sharkiteuthis/TOBI-Platform/TOBI Data.jpg

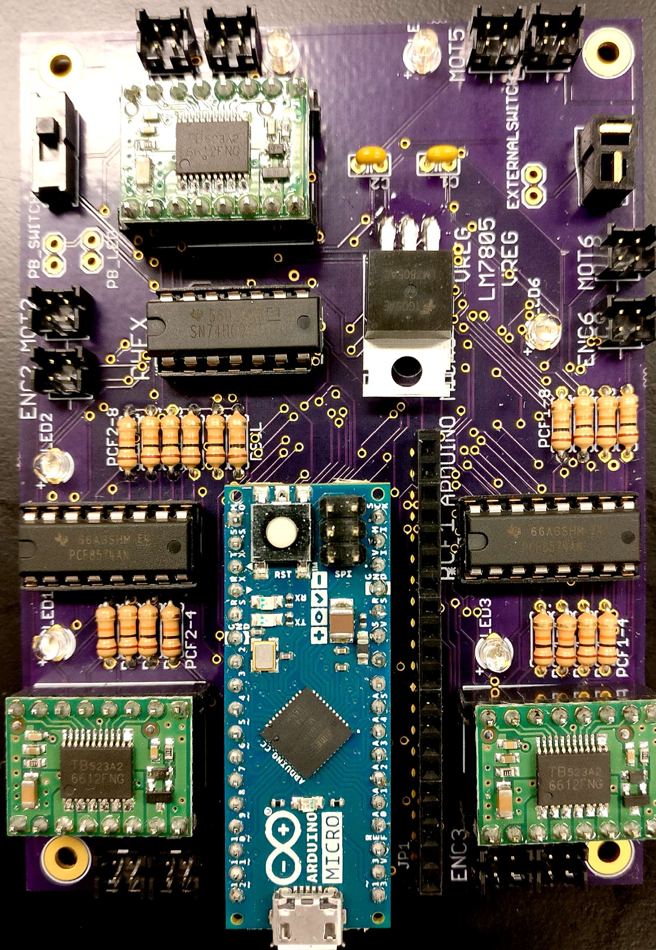
TOBI Data.jpg
