sharkiteuthis/TOBI-Platform/tobi diagram UPDATED.jpg

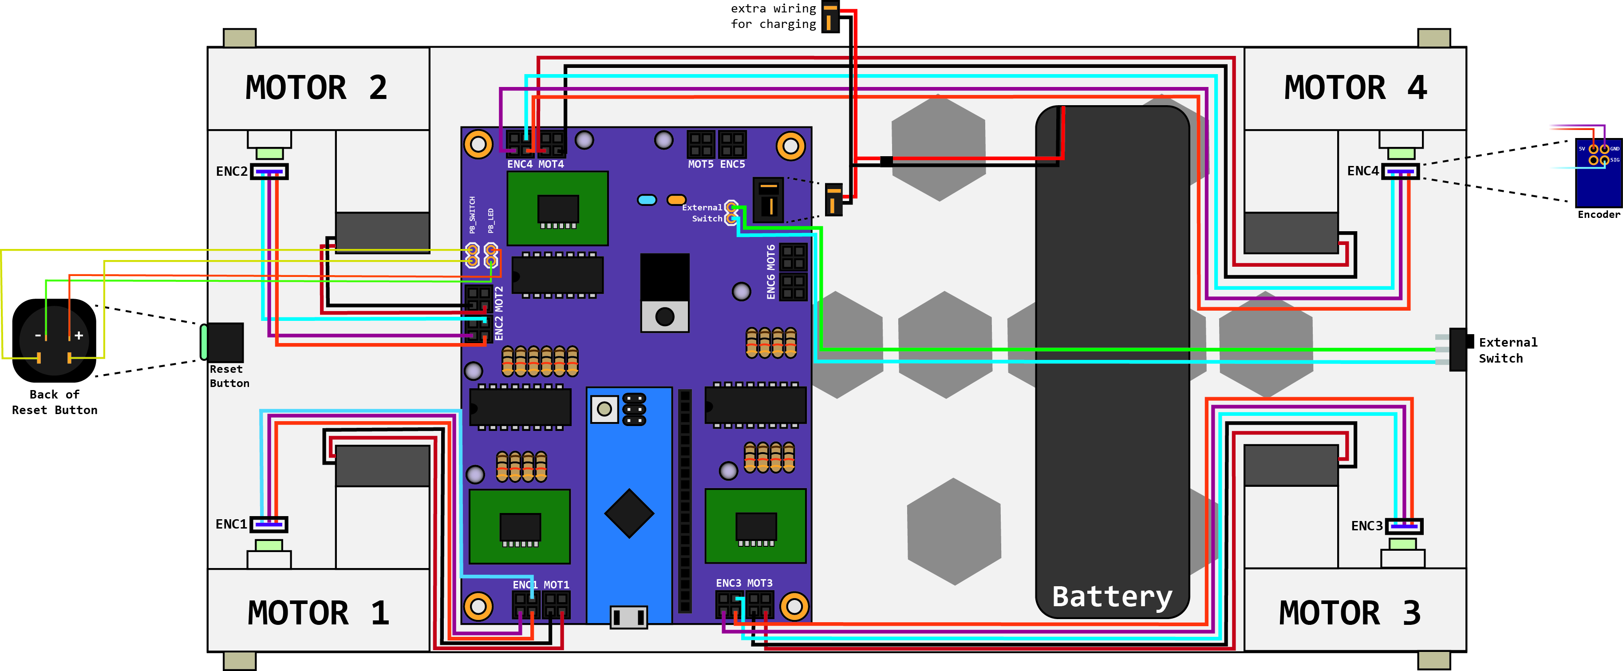
tobi diagram UPDATED.jpg
