sharkiteuthis/TOBI-Platform/TOBI - BOM.xlsx

Sheet: For robot
TOBI BOM | Per Bot | Supplier | Part No | Description | Cost | Per | cost per part | Cost per robot | URL | Notes
PCB
Custom PCB | 1 | Custom
Motor Drivers | 3 | Polulu | TB6612FNG | Dual Motor Driver Carrier | $4.25 | $1.00 | $4.25 | $12.75 | https://www.pololu.com/product/713
Female Headers 2x2 | 12 | Digikey | H2019-ND (http://www.digikey.com/scripts/DkSearch/dksus.dll?Detail&itemSeq=222470643&uq=636255435022141425) | CONN SOCKET 4POS 2MM DUAL CRIMP | $6.86 | $50.00 | $0.14 | $1.65 | https://www.digikey.com/products/en?keywords=H2019-ND
Male Headers 2x2 | 12 | Digikey | H10229-ND | CONN HEADER 4POS 2MM PCB TIN | $29.90 | $100.00 | $0.30 | $3.59 | https://www.digikey.com/products/en?keywords=H10229-ND
IO Expander | 2 | Digikey | 296-13106-5-ND | IC I/O EXPANDER I2C 8B 16DIP | $28.90 | $24.00 | $1.20 | $2.41 | https://www.digikey.com/products/en?keywords=296-13106-5-ND
Hex Inverter | 1 | Digikey | 296-1566-5-ND | Hex Inverter | $0.52 | $1.00 | $0.52 | $0.52 | https://www.digikey.com/product-detail/en/texas-instruments/SN74HC04N/296-1566-5-ND/277212
Voltage Regulator | 1 | Digikey | LM7805ACT-ND | IC REG LDO 5V 1A TO220-3 | $6.37 | $12.00 | $0.53 | $0.53 | https://www.digikey.com/products/en?keywords=LM7805ACT-ND
Resistors 10 k-ohm | 18 | Digikey | CF14JT10K0TR-ND | RES 10K OHM 1/4W 5% AXIAL | $23.75 | $5000.00 | $0.00475 | $0.09 | https://www.digikey.com/products/en?keywords=CF14JT10K0TR-ND
Femal Headers 1x20 | 8 | Digikey | S7018-ND | CONN HEADER FEMALE 20POS.1" TIN | $12.72 | $10.00 | $1.27 | $10.18 | https://www.digikey.com/products/en?keywords=S7018-ND
Arduino Micro | 1 | Pololu | Micro | Arduino Micro | $24.95 | $1.00 | $24.95 | $24.95 | https://www.pololu.com/product/2188
Capacitor 0.33 (Vreg) | 1 | Digikey | 490-7544-1-ND | AP CER 0.33UF 50V X7R RADIAL | $3.95 | $10.00 | $0.40 | $0.40 | https://www.digikey.com/products/en?keywords=490-7544-1-ND
Capacitor 0.1(Vreg) | 1 | Digikey | BC1160CT-ND | 0.1µF -20%, +80% 50V Ceramic Capacitor Y5V (F) Radial | $1.27 | $10.00 | $0.13 | $0.13 | https://www.digikey.com/products/en?keywords=BC1160CT-ND
Inverter Header | 1 | Digikey | AE9989-ND | CONN IC DIP SOCKET 14POS TIN | $0.23 |  |  |  | http://www.digikey.com/scripts/DkSearch/dksus.dll?Detail&itemSeq=231988762&uq=636343278581042423
I/O Expander Header | 2 | Digikey | AE9992-ND | CONN IC DIP SOCKET 16POS TIN | $0.25 |  |  |  | http://www.digikey.com/scripts/DkSearch/dksus.dll?Detail&itemSeq=231988761&uq=636343278581042423
Switch | 2 | Digikey | EG1903-ND | SWITCH SLIDE SPDT 200MA 30V | $0.58 |  |  |  | http://www.digikey.com/scripts/DkSearch/dksus.dll?Detail&itemSeq=231988763&uq=636343278581052424
LED | 1 | Digikey | R2D-1.5-BLU-ND | ORCA ADAPTER LT PIPE BLUE 3.4V (1=100 qty) | $2.32 |  |  |  | https://www.digikey.com/products/en?keywords=R2D-1.5-BLU-ND
Reset Button | 1 | Adafruit | 1440 | 16mm Illuminated Pushbutton - Green Momentary | $1.50 |  |  |  | https://www.adafruit.com/product/1440
Total |  |  |  |  |  |  |  | 57.17706667
Motors
Magnets | 6 | Digikey | 469-1024-ND | MAGNET ROUND NDFEB DIAMETRIC | $22.75 | 100 | 0.2275 | 1.365 | http://www.digikey.com/product-detail/en/radial-magnet-inc/8995/469-1024-ND/5126077
Motors | 6 | Polulu | GM8 143:1 | Solarbotics | 5.4 | 1 | 5.4 | 32.4 | https://www.pololu.com/product/187
Crimps | 30 | Digikey | H1504-ND | CONN SOCKET 24-28AWG CRIMP TIN | $18.75 | 250 | 0.075 | 2.25 | https://www.digikey.com/products/en/connectors-interconnects/rectangular-connectors-contacts/331?k=H1504-ND
Heat Shrink | 1 | Digikey | FP316K-R5-ND | HEATSHRK FP301 3/16"X0.5" (1=50 qty) | 1.5 | 50 | 0.03 | 0.03 | https://www.digikey.com/products/en?keywords=FP316K-R5-ND
Total |  |  |  |  |  |  |  | 36.015
Sensors
PCB Sensor Custom | 1 | Custom
Hall effect sensor | 6 | Digikey | AS5600-ASOMCT-ND | IC SENSOR MAG ROTARY 12BIT 8SOIC | 31.16 | 10 | 3.116 | 18.696 | https://www.digikey.com/products/en?keywords=AS5600-ASOMCT-ND
capacitor 0.1 uF | 1 | Digikey | 311-1369-6-ND | CAP CER 0.1UF 16V Y5V 0603 | 0.32 | 10 | 0.032 | 0.032 | https://www.digikey.com/products/en?keywords=%09311-1369-6-ND
capacitor 1 uF | 1 | Digikey | 311-1372-6-ND | CAP CER 1UF 16V Y5V 0603 | 0.89 | 10 | 0.089 | 0.089 | https://www.digikey.com/products/en?keywords=311-1372-6
Total |  |  |  |  |  |  |  | 18.728
Power
Batteries | 1 | Maxxpacks | #K708F | 1 9.6v 700mah NiMH 2/3 AA Pack | $36.00 | 1 | 36 | 36 | https://www.maxxpacks.com/product_info.php?products_id=2254%7B1%7D108 | 24 AWG Leads
Mini T connectors (Pair) | 4 | HobbyKing | 258000111-0 | Mini Black T Connector Pack (1=5 Pairs) | $2.24 | 5 | 0.448 | 1.792 | https://hobbyking.com/en_us/mini-black-t-connector-pack-5-pairs.html/?___store=en_us | Also called Mini-deans connectors | http://www.progressiverc.com/mini-t-plug-connectors.html
Total |  |  |  |  |  |  |  | 37.792
Body |  | Shapeways |  | Top and Bottom STL files
3D Print body | 1
3D Print motor hubs | 6
3D Print magnet hubs | 6
Breadboard | 1 | Adafruit | Half-size breadboard | PRODUCT ID: 64 | 5 | 1 | 5 | 5 | https://www.adafruit.com/product/64
Body bolts
PCB bolts
PCB nuts
Total
Grand total 1 bot |  |  |  |  |  |  |  | 113.6970667

Sheet: Tools
Extras + Tools
Wire cutters/strippers | 1
Crimper | 1 | Digikey | H9995-ND | Crimper | 1052.7 |  |  | https://www.digikey.com/product-detail/en/hirose-electric-co-ltd/DF11-TA2428HC/H9995-ND/141476
Soldering Iron | 1 | Digikey | WES51 | Weller Soldering station | $129 | 1 |  | https://www.digikey.com/product-detail/en/apex-tool-group/WES51/WES51-120V-ND/526397?WT.srch=1
Battery Charger | 1 | Maxxpacks | IMAX B6AC DUAL POWER LiPO AC/DC PEAK CHARGER AC & DC INPUT |  | $34.95 | 1 | 34.95 | https://www.maxxpacks.com/product_info.php?cPath=53_248&products_id=3184
Heat shrink gun | 1 | Master Appliance | PH-2200-1-A1-ND | Heat Shrink Gun | 185.98 |  |  | https://www.digikey.com/product-detail/en/master-appliance-co/PH-2200-1-A1/PH-2200-1-A1-ND/1765524
Screw driver | 1 | Philips head
Solder wire | 1 | Amazon |  | BNTECHGO 3Pack Solder Wire Dia.1.0mm/0.039 Inch Sn99 Ag0.3 Cu0.7 Flux 2.0% Rosin Core Net Weight 0.71 Oz/20g | 10.98 | 3 |  | https://www.amazon.com/dp/B01N9SD9XA
Solder Paste | 1 | Digikey |  | Solder Paste |  |  |  | https://www.digikey.com/product-detail/en/chip-quik-inc/SMDLTLFP/SMDLTLFP-ND/2682721
Twezers | 1
Smoke Absorber | 1 | Digikey | 243-1189-ND | Aven Smoke Absorber | 52.05 | 1 |  | https://www.digikey.com/product-detail/en/aven-tools/17701/243-1189-ND/2815652
Brass Sponge | 1 | Digikey | 243-1157-ND | Aven Brass Sponge | 4.49 | 1 |  | https://www.digikey.com/product-detail/en/aven-tools/17530-TC/243-1157-ND/4926916
Micro USB
Wire Cutters | 1 | Digikey | LC665J-ND | Apex | $38 |  |  | https://www.digikey.com/product-detail/en/apex-tool-group/LC665J/LC665J-ND/4525229
PCB Stand | 1 | Digikey | 243-1223-ND | Aven | 13.08 |  |  | https://www.digikey.com/product-detail/en/aven-tools/17010/243-1223-ND/5252793
Solder Sucker | 1 | Digikey | 243-1182-ND | Aven | $5 |  |  | https://www.digikey.com/product-detail/en/aven-tools/17535/243-1182-ND/1992576
Multimeter | 1
