sharkiteuthis/TOBI-Platform/TOBI Order.xlsx

Vendor | Part No. | Description | Unit Qty | Qty | Total Cost | Total Cost | URL | Robots Needed
Polulu | TB6612FNG | Dual Motor Driver Carrier | 3 | 63 | 3.75 | 236.25 | https://www.pololu.com/product/713 | 21
Polulu | Polulu | GM8 143:1 | 7 | 147 | 5.4 | 793.8 | https://www.pololu.com/product/187
Digikey | H2019-ND | CONN SOCKET 4POS 2MM DUAL CRIMP | 13 | 273 | 0.11272 | 30.77256 | https://www.digikey.com/products/en?keywords=H2019-ND
Digikey | H10229-ND | CONN HEADER 4POS 2MM PCB TIN | 13 | 273 | 0.242 | 66.066 | https://www.digikey.com/products/en?keywords=H10229-ND
Digikey | 296-13106-5-ND | IC I/O EXPANDER I2C 8B 16DIP | 1 | 21 | 1.204 | 25.284 | https://www.digikey.com/products/en?keywords=296-13106-5-ND
Digikey | LM7805ACT-ND | IC REG LDO 5V 1A TO220-3 | 1 | 21 | 0.531 | 11.151 | https://www.digikey.com/products/en?keywords=LM7805ACT-ND
Digikey | CF14JT10K0TR-ND | RES 10K OHM 1/4W 5% AXIAL | 20 | 420 | 0.0099 | 4.158 | https://www.digikey.com/products/en?keywords=CF14JT10K0TR-ND
Digikey | S7018-ND | CONN HEADER FEMALE 20POS.1" TIN | 9 | 189 | 0.942 | 178.038 | https://www.digikey.com/products/en?keywords=S7018-ND
Digikey | 490-7544-1-ND | AP CER 0.33UF 50V X7R RADIAL | 2 | 42 | 0.435 | 18.27 | https://www.digikey.com/products/en?keywords=490-7544-1-ND
Digikey | BC1160CT-ND | 0.1µF -20%, +80% 50V Ceramic Capacitor Y5V (F) Radial | 2 | 42 | 0.127 | 5.334 | https://www.digikey.com/product-detail/en/vishay-bc-components/K104Z15Y5VF5TL2/BC1160CT-ND/286782
Digikey | 469-1024-ND | MAGNET ROUND NDFEB DIAMETRIC | 7 | 147 | 0.1697 | 24.9459 | https://www.digikey.com/products/en?keywords=469-1024-ND
Digikey | H1504-ND | CONN SOCKET 24-28AWG CRIMP TIN | 36 | 756 | 0.072 | 54.432 | https://www.digikey.com/products/en/connectors-interconnects/rectangular-connectors-contacts/331?k=H1504-ND
Digikey | FP316K-R5-ND | HEATSHRK FP301 3/16"X0.5" 1=50PC | 1 | 21 | 1.122 | 23.562 | https://www.digikey.com/products/en?keywords=FP316K-R5-ND
Digikey | AS5600-ASOMCT-ND | IC SENSOR MAG ROTARY 12BIT 8SOIC | 7 | 147 | 2.5797 | 379.2159 | https://www.digikey.com/products/en?keywords=AS5600-ASOMCT-ND
Digikey | 311-1369-6-ND | CAP CER 0.1UF 16V Y5V 0603 | 2 | 42 | 0.033 | 1.386 | https://www.digikey.com/products/en?keywords=%09311-1369-6-ND
Digikey | 311-1372-6-ND | CAP CER 1UF 16V Y5V 0603 | 2 | 42 | 0.094 | 3.948 | https://www.digikey.com/products/en?keywords=311-1372-6
Maxxpacks | #K708F | 1 9.6v 700mah NiMH 2/3 AA Pack w/ 24 AWG leads | 1 | 21 | 29.45 | 618.45 | https://www.maxxpacks.com/product_info.php?products_id=2254%7B1%7D108
HobbyKing | 258000111-0 | Mini Black T Connector Pack (1=5 Pairs) | 1 | 21 | 2.38 | 49.98 | https://hobbyking.com/en_us/mini-black-t-connector-pack-5-pairs.html/?___store=en_us
Adafruit | 64 | Half-Size Breadboard | 1 | 21 | 5 | 105 | https://www.adafruit.com/product/64
Arduino |  | Arduino Micro | 1 | 21 | 24.95 | 523.95 | https://store-usa.arduino.cc/products/a000053
OSH Park |  | PCB - Main | 1 | 22 | 150.27 | 3305.94 | https://oshpark.com/
OSH Park |  | PCB - Encoder | 6 | 126 | 0.4 | 50.4 | https://oshpark.com/
 |  |  |  |  | Total | 6510.33336
