sharkiteuthis/TOBI-Platform/PCB Files/TobiEncAS5600/Encoder BOM.xlsx

Component Description | QTY | Ref Des | Mfg P/N # | Manufacturer | Distributor P/N # | Notes:
IC SENSOR MAG ROTARY 12BIT 8SOIC | 1 | U1 | AS5600-ASOM | AMS | AS5600-ASOMCT
CAP CER 0.1UF 16V X7R 0603 | 1 | C2 | C0603C104M4RACTU | KEMET | 399-1099-1-ND | Any equivalent from different manufacturer is acceptable
CAP CER 1UF 16V X7R 0603 | 1 | C3 | CGA3E1X7R1C105M080AC | TDF Corporation | 445-12540-1-ND | Any equivalent from different manufacturer is acceptable
CONN HEADER 3 POS 2.54 | 1 | JP1 | 61300311121 | Wurth Electronics | DNI
