sharkiteuthis/TOBI-Platform/Solidworks files/ArduinoTobi_slim/slim_arduino_tobi_whole.SLDPRT

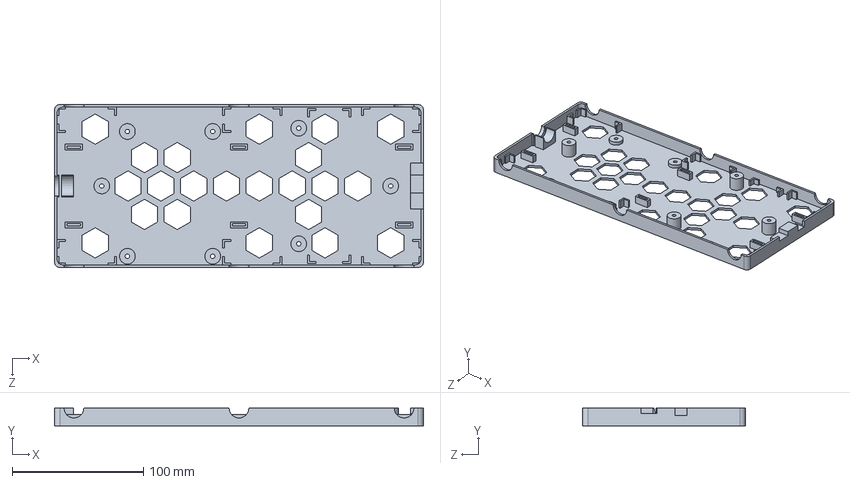
[picture p4: CAD file, 2017-12-02]
Solidworks files/ArduinoTobi_slim/slim_arduino_tobi_whole.SLDPRT
281.0 x 13.5 x 124.0 mm
