sharkiteuthis/TOBI-Platform/Solidworks files/assemblyCasing.SLDPRT

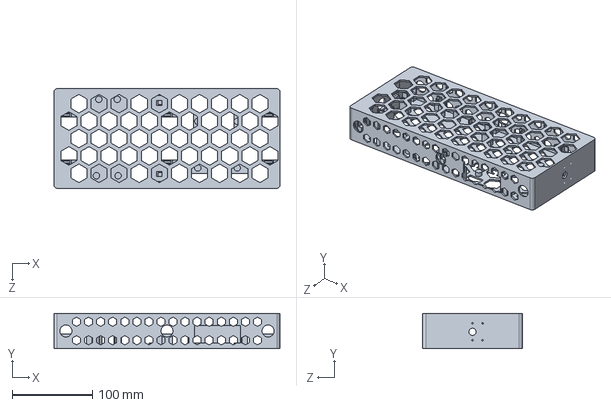
[picture p5: CAD file, 2017-12-02]
Solidworks files/assemblyCasing.SLDPRT
281.0 x 44.0 x 124.0 mm
