sharkiteuthis/TOBI-Platform/Solidworks files/t_hub_short.SLDPRT

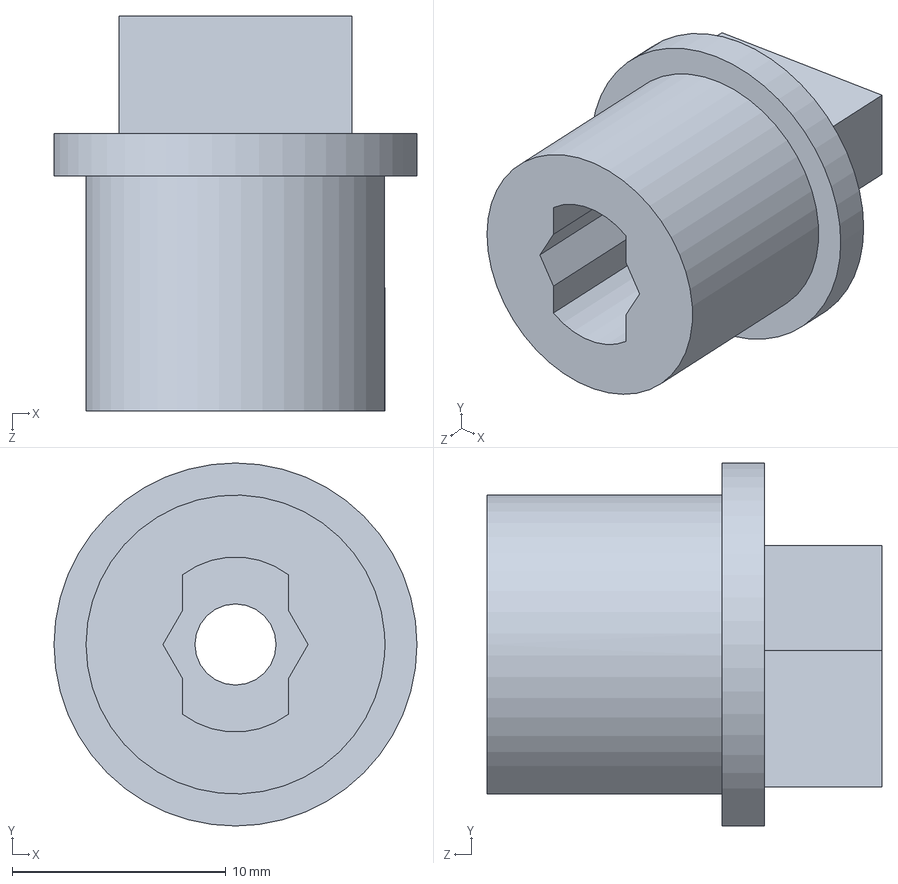
[picture p6: CAD file, 2017-12-02]
Solidworks files/t_hub_short.SLDPRT
17.0 x 17.0 x 18.5 mm
