sharkiteuthis/TOBI-Platform/Solidworks files/ArduinoTobi_slim/Body3.sldprt

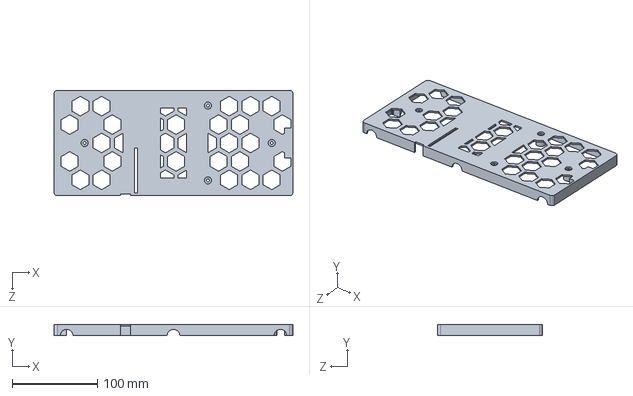
[picture p7: CAD file, 2017-12-02]
Solidworks files/ArduinoTobi_slim/Body3.sldprt
281.0 x 13.5 x 124.0 mm
