sharkiteuthis/TOBI-Platform/Solidworks files/battery holder.SLDPRT

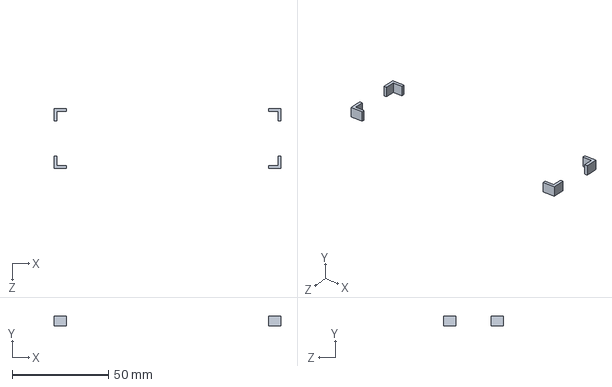
[picture p8: CAD file, 2017-12-02]
Solidworks files/battery holder.SLDPRT
118.0 x 5.00 x 31.0 mm
