sharkiteuthis/TOBI-Platform/Solidworks files/ArduinoTobi_slim/Body2.sldprt

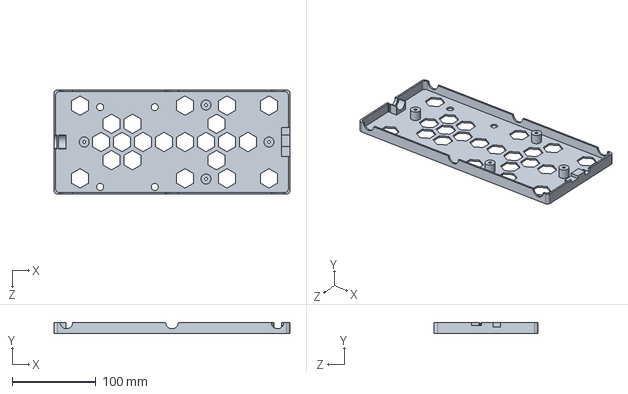
[picture p9: CAD file, 2017-12-02]
Solidworks files/ArduinoTobi_slim/Body2.sldprt
281.0 x 13.3 x 124.0 mm
