sharkiteuthis/TOBI-Platform/Solidworks files/Body1.sldprt

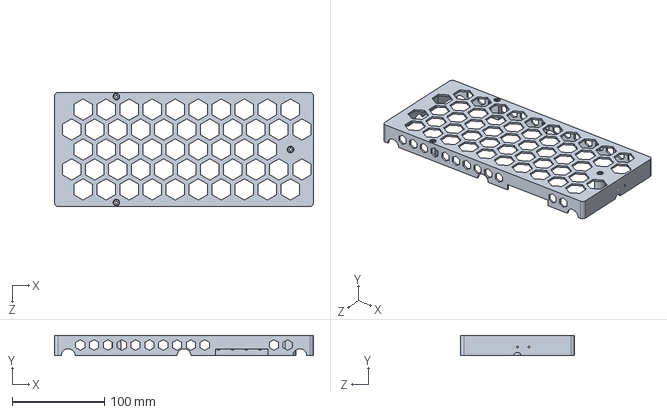
[picture p10: CAD file, 2017-12-02]
Solidworks files/Body1.sldprt
281.0 x 22.0 x 124.0 mm
