sharkiteuthis/TOBI-Platform/Solidworks files/ArduinoTobi_slim/Body1.sldprt

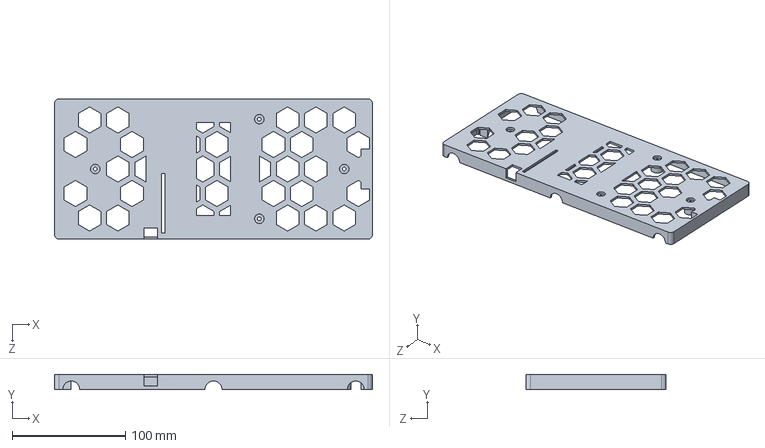
[picture p11: CAD file, 2017-12-02]
Solidworks files/ArduinoTobi_slim/Body1.sldprt
281.0 x 13.2 x 124.0 mm
