sharkiteuthis/TOBI-Platform/Solidworks files/t_hub_Long.SLDPRT

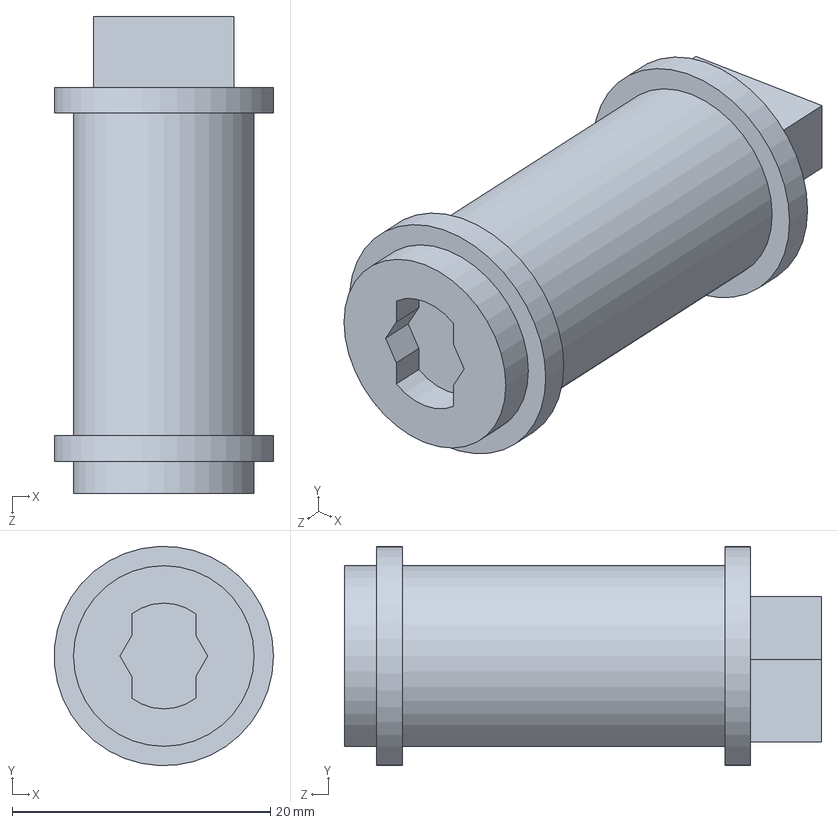
[picture p12: CAD file, 2017-12-02]
Solidworks files/t_hub_Long.SLDPRT
17.0 x 17.0 x 37.0 mm
