sharkiteuthis/TOBI-Platform/Solidworks files/slim_arduino_tobi_topV2.STL

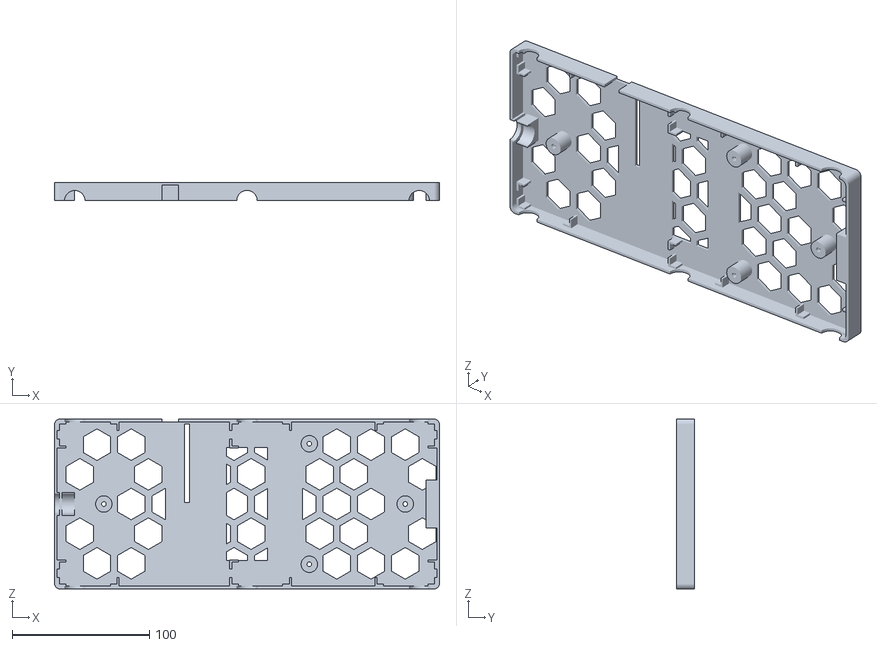
[picture p13: CAD file, 2017-12-02]
Solidworks files/slim_arduino_tobi_topV2.STL
281.0 x 13.5 x 124.0
