sharkiteuthis/TOBI-Platform/Solidworks files/ArduinoTobi_slim/Body4.sldprt

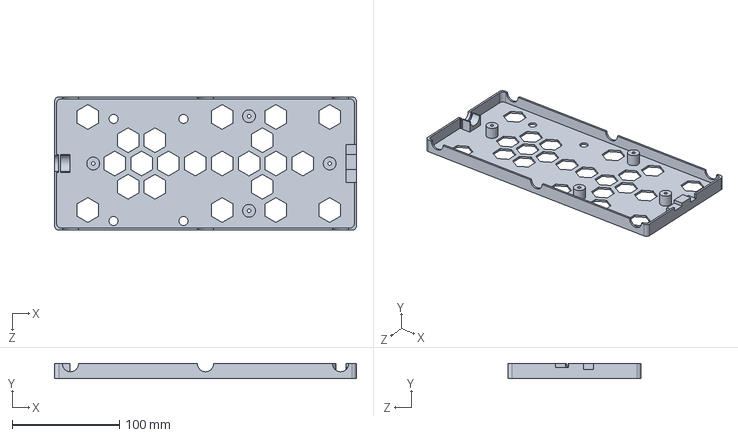
[picture p14: CAD file, 2017-12-02]
Solidworks files/ArduinoTobi_slim/Body4.sldprt
281.0 x 13.5 x 124.0 mm
