sharkiteuthis/TOBI-Platform/Solidworks files/pcb_base.SLDPRT

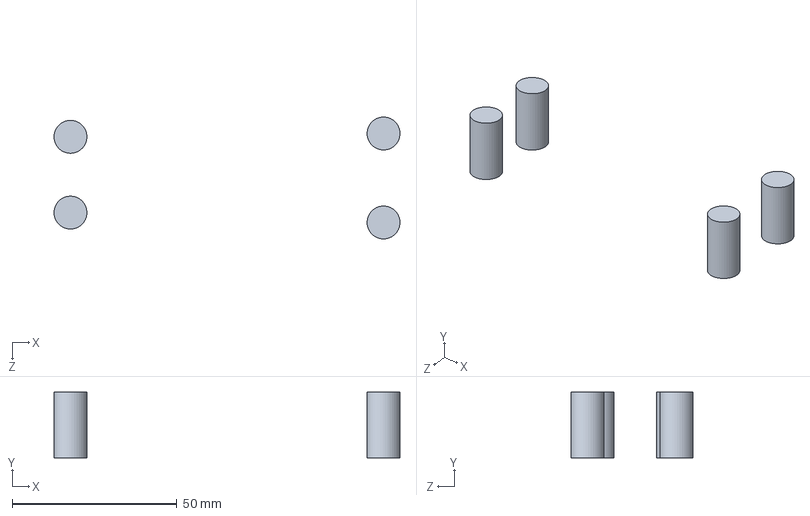
[picture p15: CAD file, 2017-12-02]
Solidworks files/pcb_base.SLDPRT
105.0 x 20.0 x 37.0 mm
