sharkiteuthis/TOBI-Platform/Solidworks files/ArduinoTobi_slim/t_hub_Long.STL

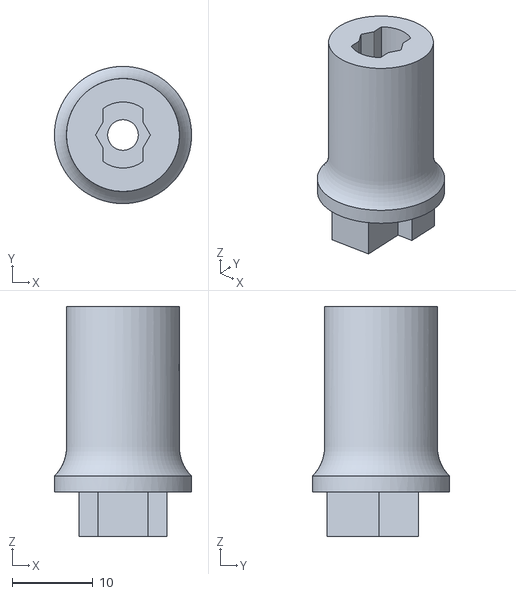
[picture p16: CAD file, 2017-12-02]
Solidworks files/ArduinoTobi_slim/t_hub_Long.STL
17.0 x 17.0 x 28.5
