sharkiteuthis/TOBI-Platform/Solidworks files/Body_bottom.sldprt

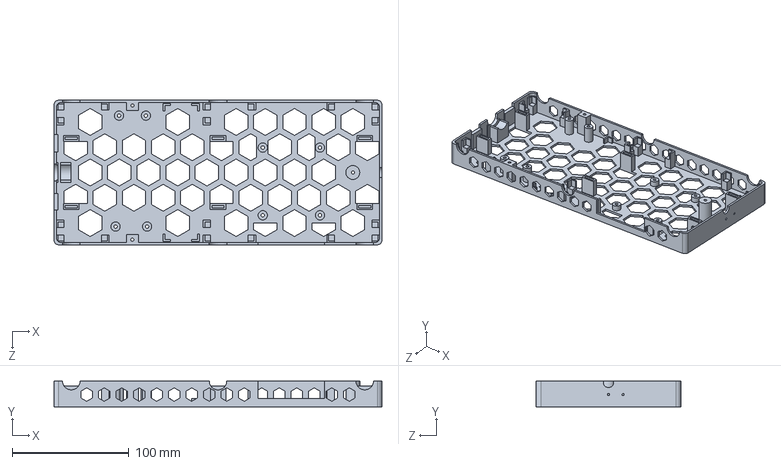
[picture p17: CAD file, 2017-12-02]
Solidworks files/Body_bottom.sldprt
281.0 x 22.0 x 124.0 mm
