sharkiteuthis/TOBI-Platform/Solidworks files/magHolder.SLDPRT

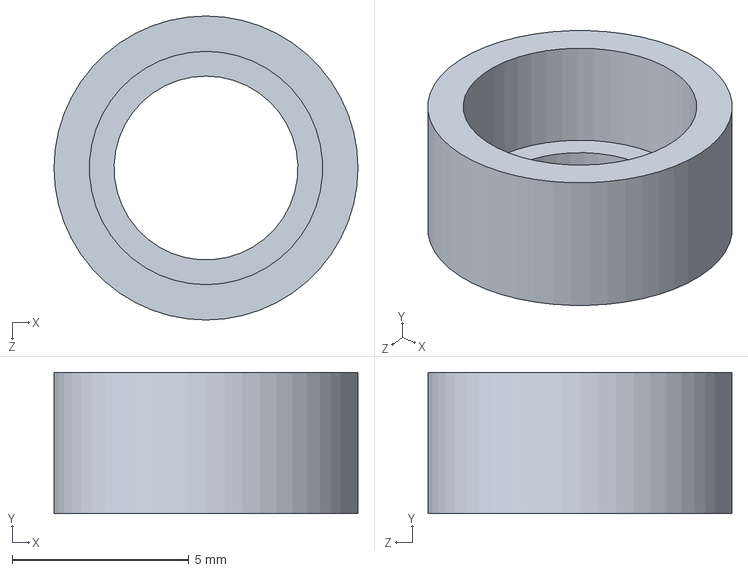
[picture p18: CAD file, 2017-12-02]
Solidworks files/magHolder.SLDPRT
8.60 x 4.00 x 8.60 mm
