sharkiteuthis/TOBI-Platform/Solidworks files/C_leg.SLDPRT

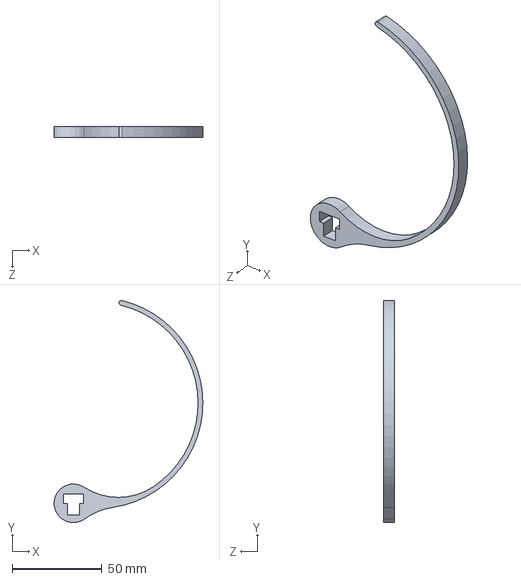
[picture p19: CAD file, 2017-12-02]
Solidworks files/C_leg.SLDPRT
83.0 x 123.9 x 6.35 mm
