sharkiteuthis/TOBI-Platform/Solidworks files/motor holder.SLDPRT

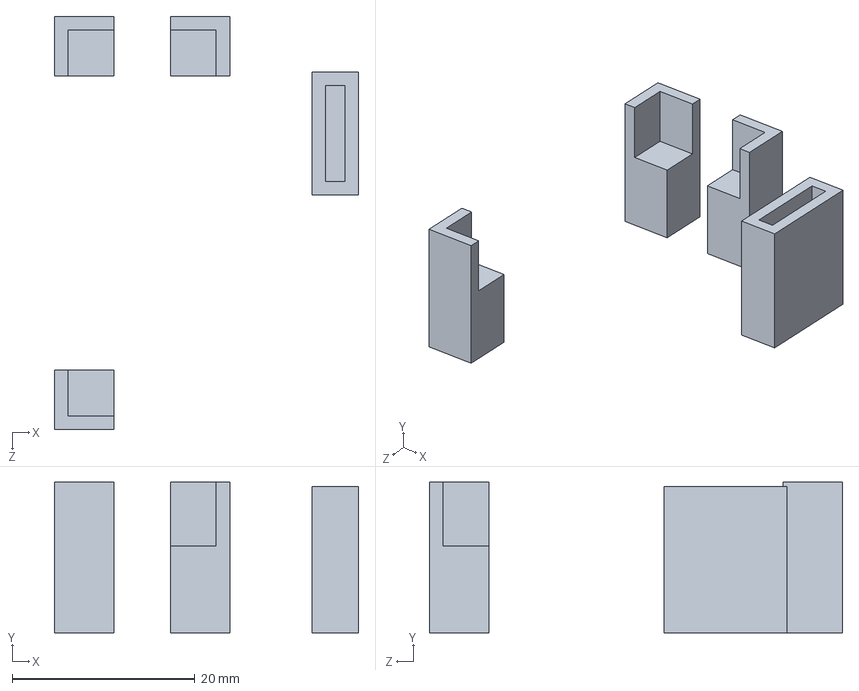
[picture p20: CAD file, 2017-12-02]
Solidworks files/motor holder.SLDPRT
33.3 x 16.5 x 45.2 mm
