sharkiteuthis/TOBI-Platform/Solidworks files/Copy of c_leg_t.SLDPRT

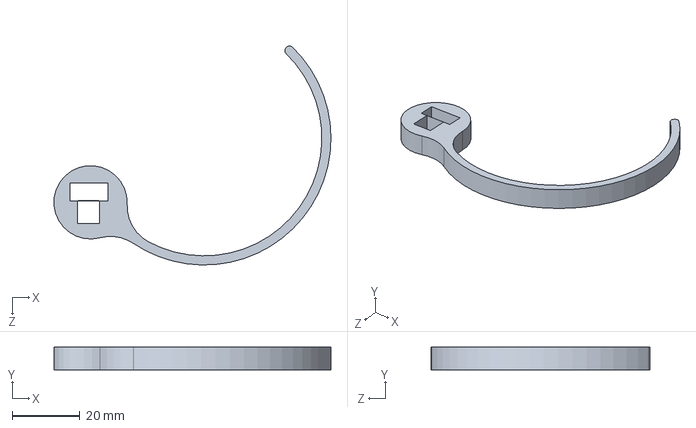
[picture p21: CAD file, 2017-12-02]
Solidworks files/Copy of c_leg_t.SLDPRT
81.6 x 6.66 x 64.5 mm
