sharkiteuthis/TOBI-Platform/Solidworks files/Body2.sldprt

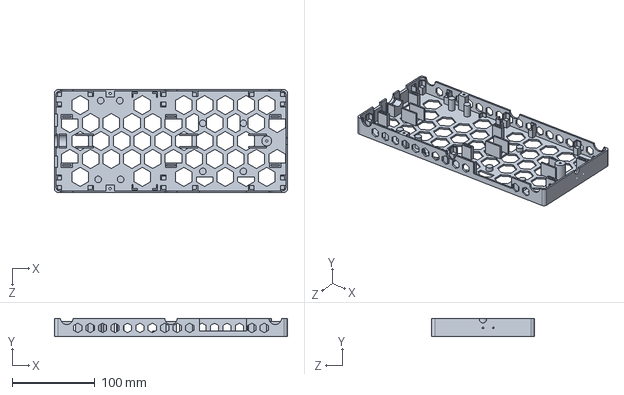
[picture p22: CAD file, 2017-12-02]
Solidworks files/Body2.sldprt
281.0 x 22.0 x 124.0 mm
