sharkiteuthis/TOBI-Platform/Solidworks files/raspi_base.SLDPRT

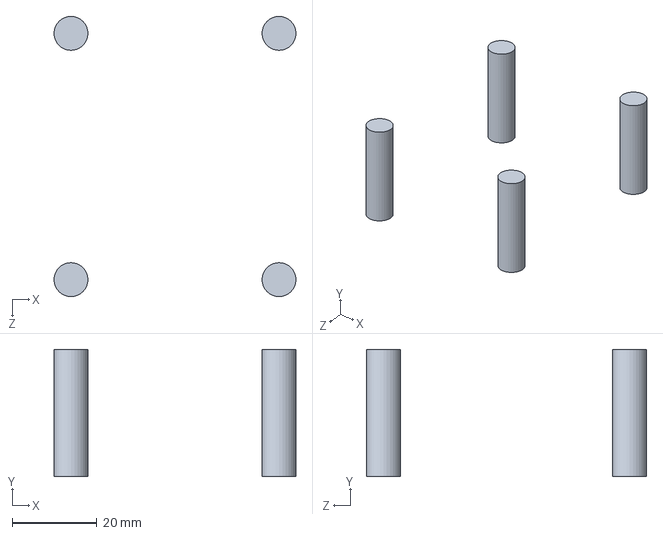
[picture p23: CAD file, 2017-12-02]
Solidworks files/raspi_base.SLDPRT
57.0 x 30.0 x 66.0 mm
