sharkiteuthis/TOBI-Platform/(list of files, cad)

Other CAD files:
Solidworks files/AssemblyTobi.SLDASM
Solidworks files/slim_arduino_tobi_bottomV2.STL
Solidworks files/ArduinoTobi_slim/C_leg.DWG
Solidworks files/ArduinoTobi_slim/C_leg+lock.DWG
Solidworks files/ArduinoTobi_slim/leglock.DWG
Solidworks files/ArduinoTobi_slim/slim_arduino_tobi_bottomV2.STL
Solidworks files/Body_top.sldprt
Solidworks files/MirrorMirrormotor holder.SLDPRT
Solidworks files/ArduinoTobi_slim/t_hub_short.STL
Solidworks files/Mirrormotor holder.SLDPRT
Solidworks files/picam holes.SLDPRT
Solidworks files/AssemblyTobi.SLDPRT
Solidworks files/OLD wheel hub.SLDPRT
Solidworks files/magHolder.STL
Solidworks files/t_hub_Long.STL
Solidworks files/t_hub_short.STL
