sharkiteuthis/TOBI-Platform/PCB Files/TobiV3 Aruino Version/tobi_arduino_version.brd

## EAGLE design PCB Files/TobiV3 Aruino Version/tobi_arduino_version.brd (2018-05-04)

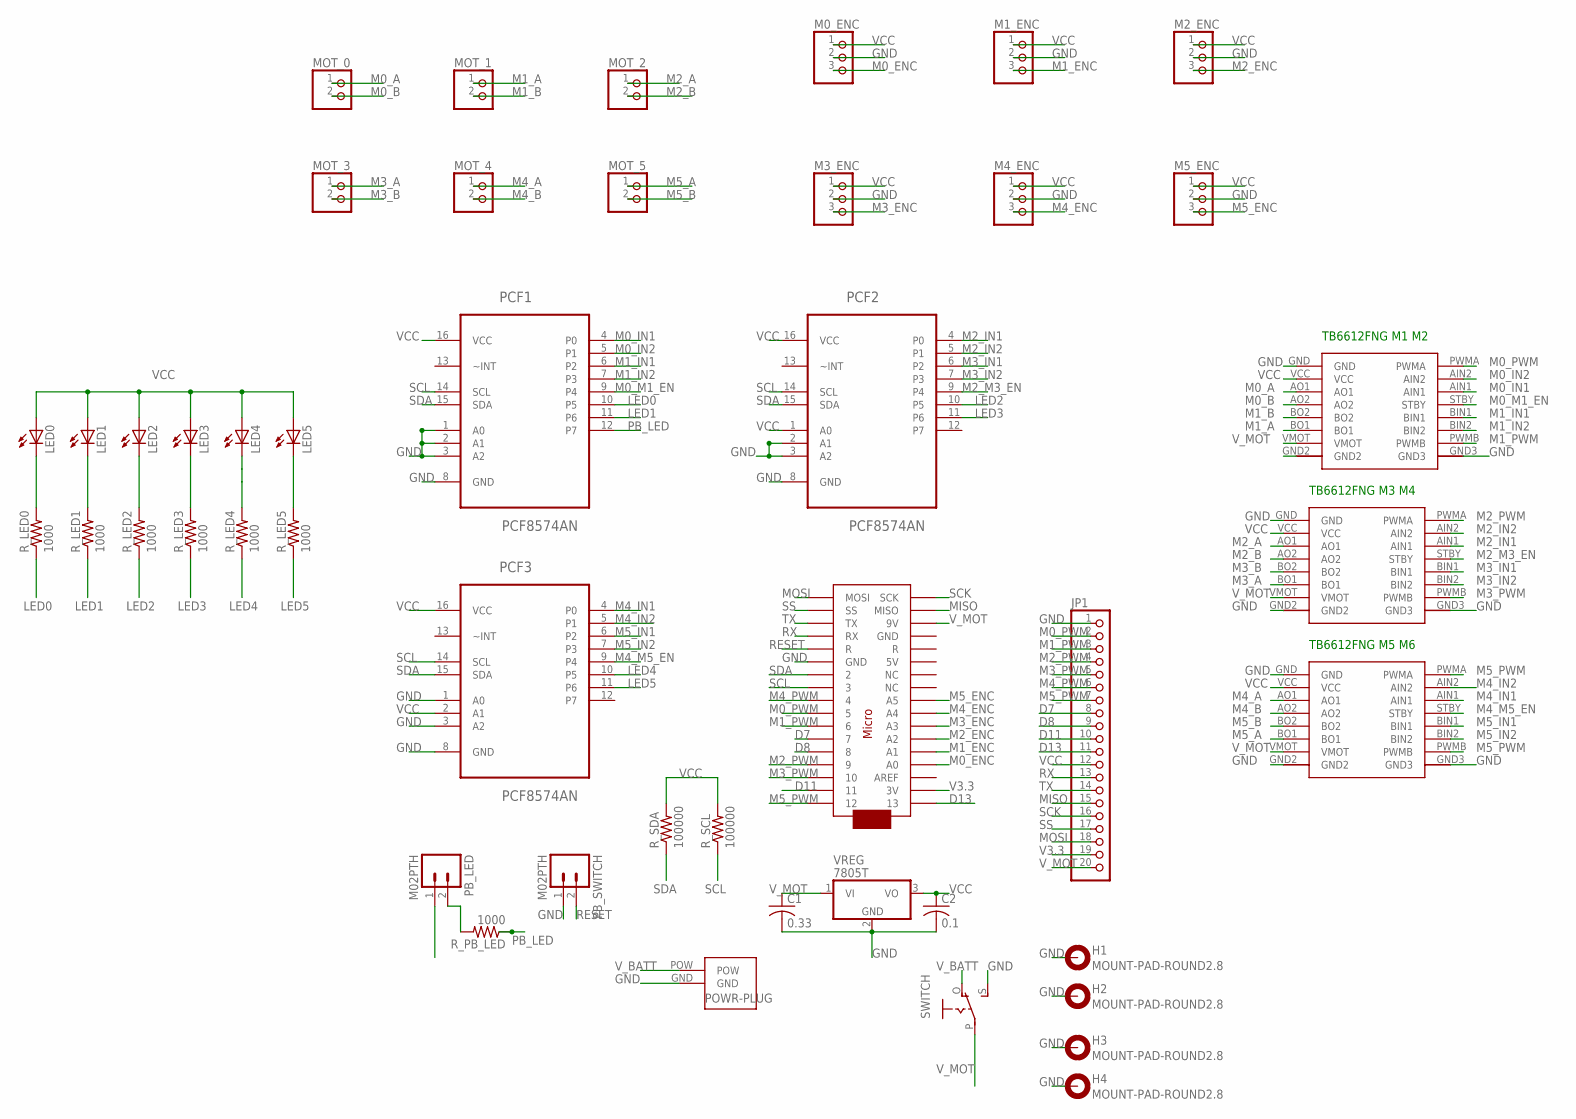
[picture p25: schematic tobi_arduino_version.sch]

Parts:
ARDUINOMICRO: ARDUINOMICRO
C1: 0.33; C025-025X050
C2: 0.1; C025-025X050
DRIVER1, DRIVER2, DRIVER3: POLOLU_MOTOR_DRV8835THROUGHHOLE; POLOLU_MOTOR_DRV_DRV8835
H1, H2, H3, H4: MOUNT-PAD-ROUND2.8; 2,8-PAD
JP1: PINHD-1X20; 1X20
LED0, LED1, LED2, LED3, LED4, LED5: LED3MM
M0_ENC, M1_ENC, M2_ENC, M3_ENC, M4_ENC, M5_ENC: PINHD-1X3; 1X03
MOT_0, MOT_1, MOT_2, MOT_3, MOT_4, MOT_5: PINHD-1X2; 1X02
PB_LED: M02PTH; 1X02
PB_SWITCH: M02PTH; 1X02
PCF1, PCF2, PCF3: PCF8574AN; DIP254P762X508-16
POWR-PLUG: MINI_DEANSSMD; MINI_DEANS
R_LED0, R_LED1, R_LED2, R_LED3, R_LED4, R_LED5: 1000; 0204V
R_PB_LED: 1000; 0204V
R_SCL: 100000; 0204V
R_SDA: 100000; 0204V
SWITCH: EG1218S; EG1218
VREG: 7805T; TO220H

Connections:
D7: ARDUINOMICRO.P$6 (7), JP1.8
D8: ARDUINOMICRO.P$5 (8), JP1.9
D11: ARDUINOMICRO.P$2 (11), JP1.10
D13: ARDUINOMICRO.P$34 (13), JP1.11
GND: ARDUINOMICRO.P$21 (GND), C1.2, C2.2, DRIVER1.GND, DRIVER1.GND2, DRIVER1.GND3, DRIVER2.GND, DRIVER2.GND2, DRIVER2.GND3, DRIVER3.GND, DRIVER3.GND2, DRIVER3.GND3, H1.B2,8, H2.B2,8, H3.B2,8, H4.B2,8, JP1.1, M0_ENC.2, M1_ENC.2, M2_ENC.2, M3_ENC.2, M4_ENC.2, M5_ENC.2, PB_SWITCH.1, PCF1.1 (A0), PCF1.2 (A1), PCF1.3 (A2), PCF1.8 (GND), PCF2.2 (A1), PCF2.3 (A2), PCF2.8 (GND), PCF3.1 (A0), PCF3.3 (A2), PCF3.8 (GND), POWR-PLUG.GND, SWITCH.S, VREG.2 (GND)
LED0: LED0.K (C), PCF1.10 (P5), R_LED0.1, R_LED0.2
LED1: LED1.K (C), PCF1.11 (P6), R_LED1.1, R_LED1.2
LED2: LED2.K (C), PCF2.10 (P5), R_LED2.1, R_LED2.2
LED3: LED3.K (C), PCF2.11 (P6), R_LED3.1, R_LED3.2
LED4: LED4.K (C), PCF3.10 (P5), R_LED4.1, R_LED4.2
LED5: LED5.K (C), PCF3.11 (P6), R_LED5.1, R_LED5.2
M0_A: DRIVER1.AO1, MOT_0.1
M0_B: DRIVER1.AO2, MOT_0.2
M0_ENC: ARDUINOMICRO.P$31 (A0), M0_ENC.3
M0_IN1: DRIVER1.AIN1, PCF1.4 (P0)
M0_IN2: DRIVER1.AIN2, PCF1.5 (P1)
M0_M1_EN: DRIVER1.STBY, PCF1.9 (P4)
M0_PWM: ARDUINOMICRO.P$8 (5), DRIVER1.PWMA, JP1.2
M1_A: DRIVER1.BO1, MOT_1.1
M1_B: DRIVER1.BO2, MOT_1.2
M1_ENC: ARDUINOMICRO.P$30 (A1), M1_ENC.3
M1_IN1: DRIVER1.BIN1, PCF1.6 (P2)
M1_IN2: DRIVER1.BIN2, PCF1.7 (P3)
M1_PWM: ARDUINOMICRO.P$7 (6), DRIVER1.PWMB, JP1.3
M2_A: DRIVER2.AO1, MOT_2.1
M2_B: DRIVER2.AO2, MOT_2.2
M2_ENC: ARDUINOMICRO.P$29 (A2), M2_ENC.3
M2_IN1: DRIVER2.AIN1, PCF2.4 (P0)
M2_IN2: DRIVER2.AIN2, PCF2.5 (P1)
M2_M3_EN: DRIVER2.STBY, PCF2.9 (P4)
M2_PWM: ARDUINOMICRO.P$4 (9), DRIVER2.PWMA, JP1.4
M3_A: DRIVER2.BO1, MOT_3.1
M3_B: DRIVER2.BO2, MOT_3.2
M3_ENC: ARDUINOMICRO.P$28 (A3), M3_ENC.3
M3_IN1: DRIVER2.BIN1, PCF2.6 (P2)
M3_IN2: DRIVER2.BIN2, PCF2.7 (P3)
M3_PWM: ARDUINOMICRO.P$3 (10), DRIVER2.PWMB, JP1.5
M4_A: DRIVER3.AO1, MOT_4.1
M4_B: DRIVER3.AO2, MOT_4.2
M4_ENC: ARDUINOMICRO.P$27 (A4), M4_ENC.3
M4_IN1: DRIVER3.AIN1, PCF3.4 (P0)
M4_IN2: DRIVER3.AIN2, PCF3.5 (P1)
M4_M5_EN: DRIVER3.STBY, PCF3.9 (P4)
M4_PWM: ARDUINOMICRO.P$9 (4), JP1.6
M5_A: DRIVER3.BO1, MOT_5.1
M5_B: DRIVER3.BO2, MOT_5.2
M5_ENC: ARDUINOMICRO.P$26 (A5), M5_ENC.3
M5_IN1: DRIVER3.BIN1, PCF3.6 (P2)
M5_IN2: DRIVER3.BIN2, PCF3.7 (P3)
M5_PWM: ARDUINOMICRO.P$1 (12), DRIVER3.PWMA, DRIVER3.PWMB, JP1.7
MISO: ARDUINOMICRO.P$19 (MISO), JP1.15
MOSI: ARDUINOMICRO.P$17 (MOSI), JP1.18
unnamed: PB_LED.2, R_PB_LED.2
PB_LED: PCF1.12 (P7), R_PB_LED.1
RESET: ARDUINOMICRO.P$22 (R), PB_SWITCH.2
RX: ARDUINOMICRO.P$14 (RX), JP1.13
SCK: ARDUINOMICRO.P$18 (SCK), JP1.16
SCL: ARDUINOMICRO.P$10 (3), PCF1.14 (SCL), PCF2.14 (SCL), PCF3.14 (SCL), R_SCL.1
SDA: ARDUINOMICRO.P$11 (2), PCF1.15 (SDA), PCF2.15 (SDA), PCF3.15 (SDA), R_SDA.1
SS: ARDUINOMICRO.P$16 (SS), JP1.17
TX: ARDUINOMICRO.P$15 (TX), JP1.14
V3.3: ARDUINOMICRO.P$33 (3V), JP1.19
VCC: C2.1, DRIVER1.VCC, DRIVER2.VCC, DRIVER3.VCC, JP1.12, LED0.A, LED1.A, LED2.A, LED3.A, LED4.A, LED5.A, M0_ENC.1, M1_ENC.1, M2_ENC.1, M3_ENC.1, M4_ENC.1, M5_ENC.1, PB_LED.1, PCF1.16 (VCC), PCF2.1 (A0), PCF2.16 (VCC), PCF3.2 (A1), PCF3.16 (VCC), R_SCL.2, R_SDA.2, VREG.3 (VO)
V_BATT: POWR-PLUG.POW, SWITCH.O
V_MOT: ARDUINOMICRO.P$20 (9V), C1.1, DRIVER1.VMOT, DRIVER2.VMOT, DRIVER3.VMOT, JP1.20, SWITCH.P, VREG.1 (VI)

Notes on the sheet:
TB6612FNG M3 M4
TB6612FNG M1 M2
TB6612FNG M5 M6

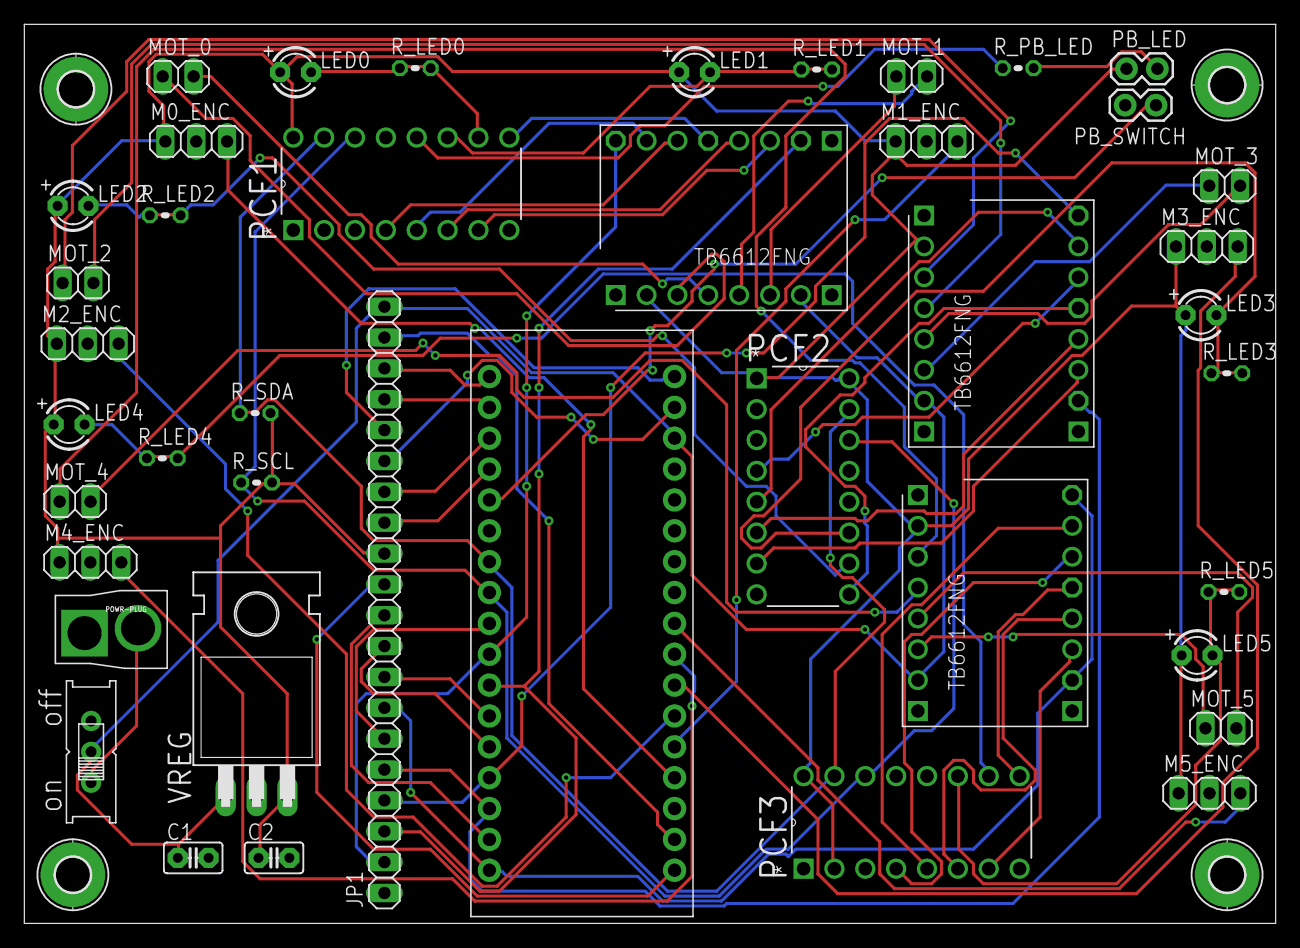
[picture p26: board tobi_arduino_version.brd from above]

Board: 2 copper layers, 103.0 x 74.0 mm, 46 parts (0 on the bottom side), 65 nets.
