sharkiteuthis/TOBI-Platform/(commit log)

2017-12-14 removed hex encoder, moved to 0-based
    [tobi_arduino_version.brd, tobi_arduino_version.sch]
2017-12-21 changed pwm pins, added series LED resistors
    [tobi_arduino_version.sch]
2017-12-27 fix motor pwm pins
    [tobi_arduino_version.sch]
2017-12-27 simple headers for encoders and motors
    [tobi_arduino_version.sch]
2018-03-03 moved some components around
    [tobi_arduino_version.brd]
2018-03-03 position components for wider encoder board
    [TobiEncAS5600.brd, TobiEncAS5600.sch]
2018-03-03 double wide encoder board
    [TobiEncAS5600.brd, TobiEncAS5600.sch]
2018-03-03 add silkscreen to board
    [TobiEncAS5600.brd]
2018-03-04 first shot at positioning components
    [tobi_arduino_version.brd, tobi_arduino_version.sch]
2018-03-04 fix a few things on the silkscreen
    [tobi_arduino_version.brd]
2018-03-04 reconciled some nets
    [tobi_arduino_version.brd, tobi_arduino_version.sch]
2018-03-04 manual routing for scl/sda lines
    [tobi_arduino_version.brd]
2018-03-04 hand route sda/scl and thick traces for motor voltage
    [tobi_arduino_version.brd]
2018-03-04 hand route gnd
    [tobi_arduino_version.brd]
2018-03-05 fix to motor 5 net
    [tobi_arduino_version.sch]
2018-03-05 route heavy traces for motor leads
    [tobi_arduino_version.brd]
2018-03-07 heavier traces on encoder board since it can accomodate them
    [TobiEncAS5600.brd]
2018-03-07 autoroute the rest of the board
    [tobi_arduino_version.brd]
2018-03-07 fix silkscreen on pushbutton LED
    [tobi_arduino_version.brd]
2018-03-07 rip up main board and try again...
    [tobi_arduino_version.brd]
2018-03-07 add ground plane
    [tobi_arduino_version.brd]
2018-03-07 add thick traces for battery voltage, motor voltage, sda, scl
    [tobi_arduino_version.brd, tobi_arduino_version.sch]
2018-03-07 route motor leads with heavy traces
    [tobi_arduino_version.brd, tobi_arduino_version.sch]
2018-03-08 autoroute the rest, i'm not happy with the vias near pcf1
    [tobi_arduino_version.brd]
2018-03-08 manual fixes to the autorouter to connect all the ground planes
    [tobi_arduino_version.brd]
2018-04-13 minor silkscreen changes
    [tobi_arduino_version.brd]
2018-04-18 add grasp url to board silkscreen
    [tobi_arduino_version.brd]
2018-04-29 fix LED hardware bugs
    [tobi_arduino_version.sch]
2018-04-29 let's try this again
    [tobi_arduino_version.brd, tobi_arduino_version.sch]
2018-04-30 no routing
    [tobi_arduino_version.brd, tobi_arduino_version.sch]
2018-05-04 fix ground plane and autorouter net settings
    [tobi_arduino_version.brd, tobi_arduino_version.sch]
2018-05-04 used autorouter
    [tobi_arduino_version.brd, tobi_arduino_version.sch]
2018-05-04 add bottom silkscreen
    [tobi_arduino_version.brd]
2018-07-05 gerber files and BOM for encoder
    [Encoder BOM.xlsx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]
2018-07-18 Encoder BOM snd gerber files
    [Encoder BOM.xlsx, TobiEncAS5600 centroid.csv]
